systemetric/RoboCon-Brain/README.md

# RoboCon-Brain
Custom hardware and firmware for the RoboCon Brain, with PCB designs, embedded software and supporting files. Generations are documented through dedicated branches.
