systemetric/RoboCon-Brain/Hardware/PCB/PiLow/PiLow.kicad_pcb

## KiCad design Hardware/PCB/PiLow/PiLow.kicad_pcb (2026-10-25)

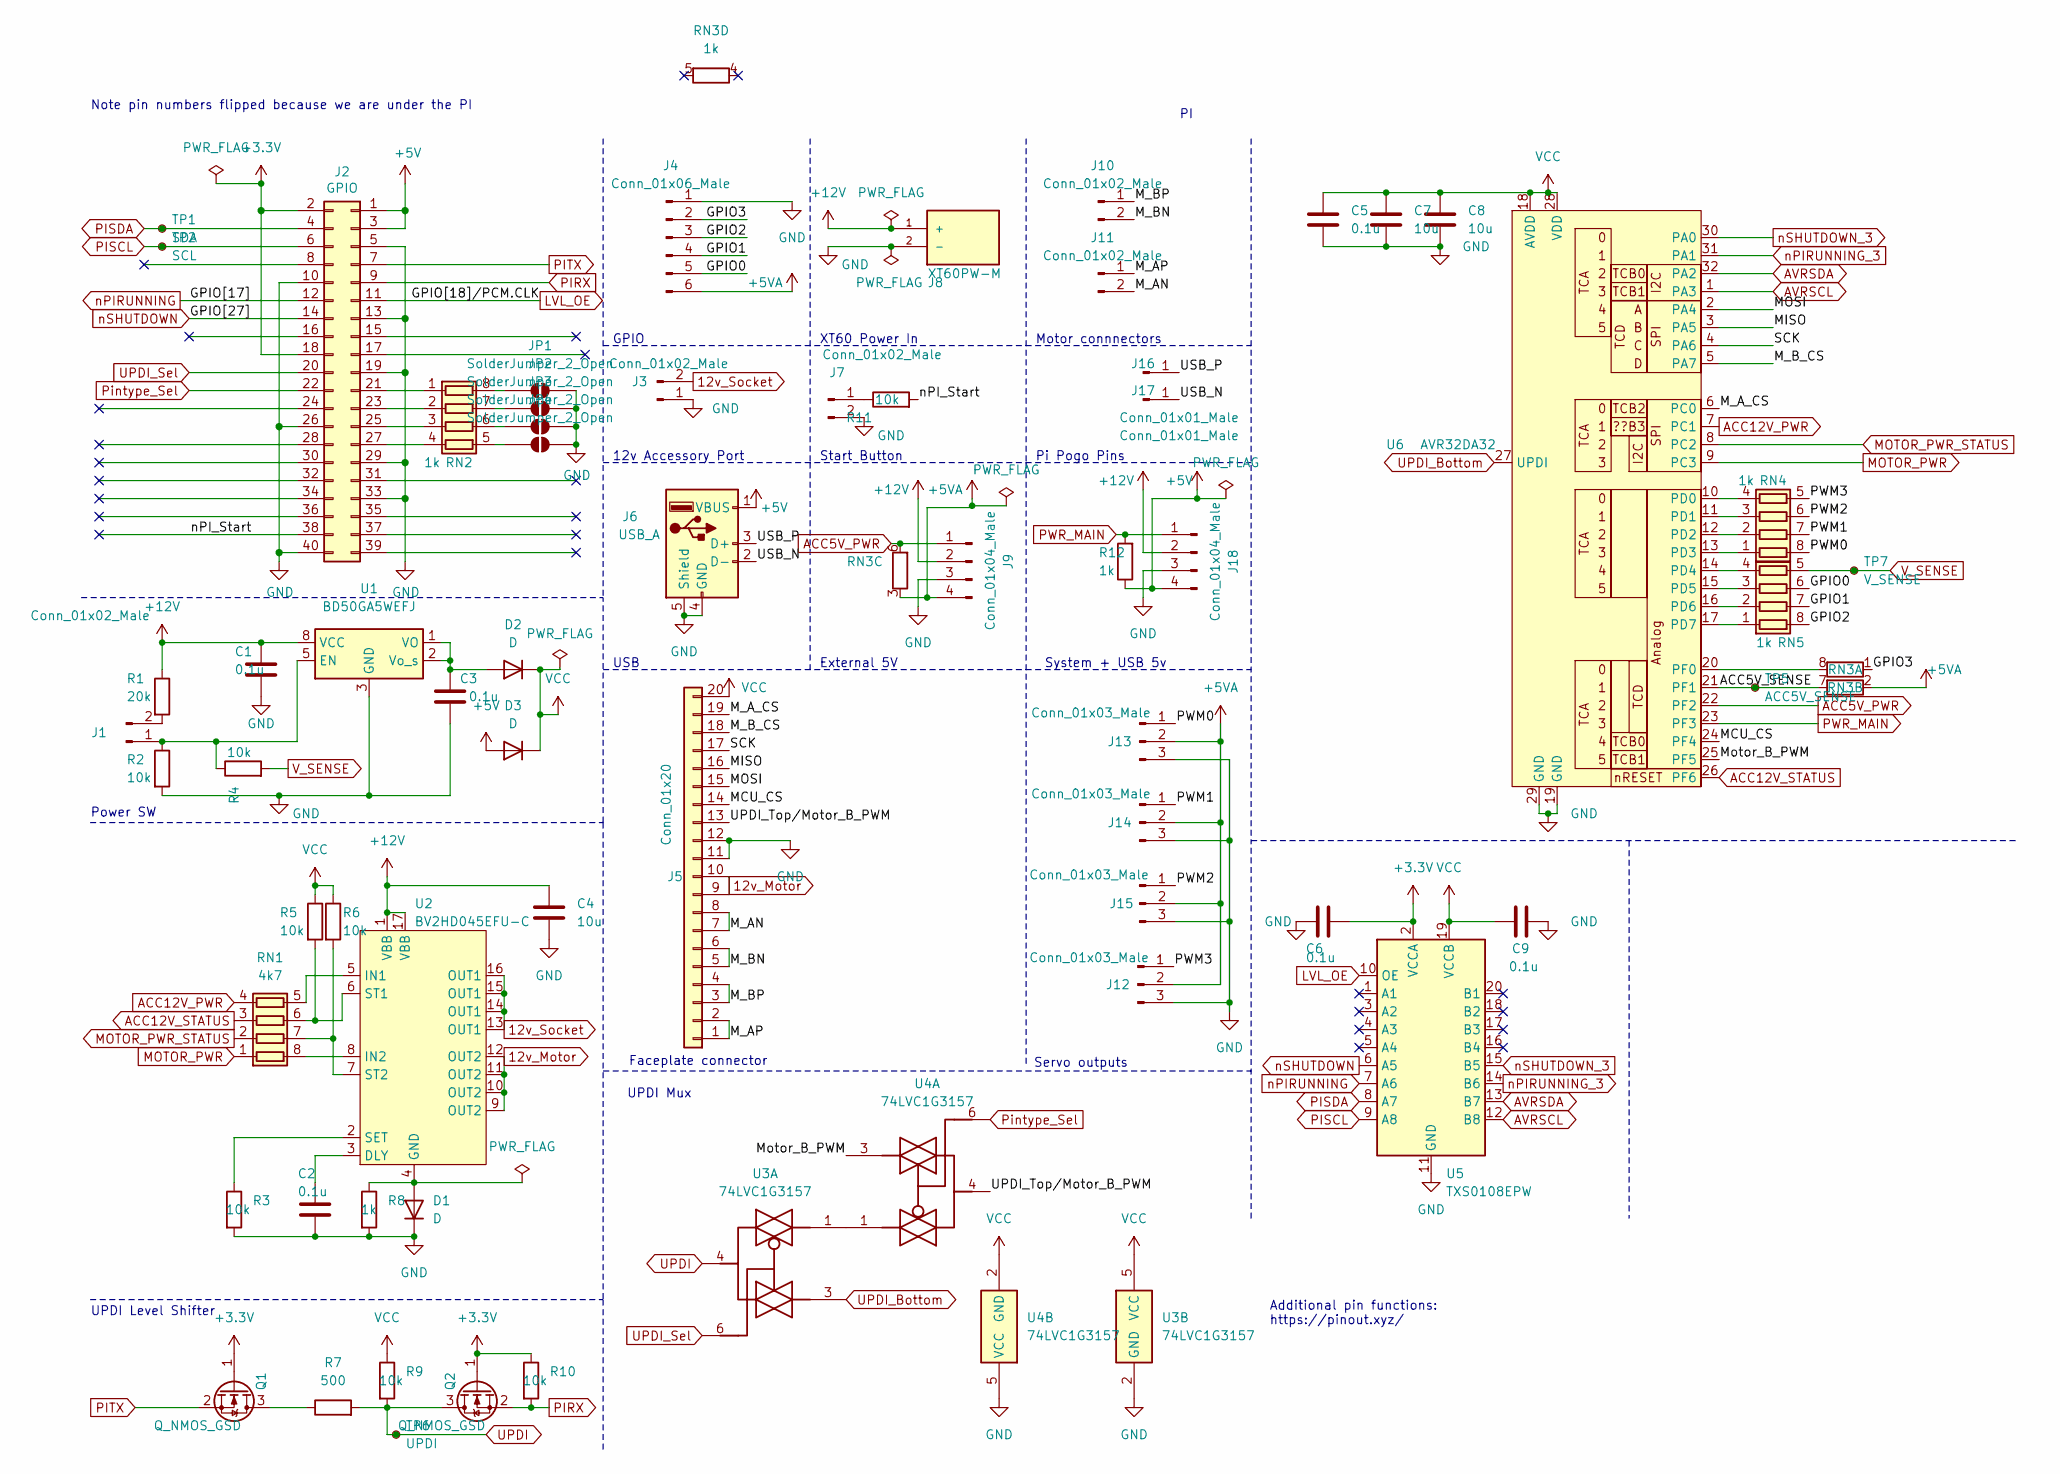
[picture p1: schematic PiLow.kicad_sch]

Parts:
C1, C2, C3, C5, C6, C9: 0.1u; C_0805_2012Metric_Pad1.18x1.45mm_HandSolder
C4, C7, C8: 10u; C_0805_2012Metric_Pad1.18x1.45mm_HandSolder
D1, D2, D3: D; D_SMA_Handsoldering
J1, J7: Conn_01x02_Male; PhoenixContact_MC_1,5_2-G-3.81_1x02_P3.81mm_Horizontal
J2: GPIO; PinSocket_2x20_P2.54mm_Vertical_SMD
J3, J10, J11: Conn_01x02_Male; PhoenixContact_MC_1,5_2-G-5.08_1x02_P5.08mm_Horizontal
J4: Conn_01x06_Male; PhoenixContact_MC_1,5_6-G-3.81_1x06_P3.81mm_Horizontal
J5: Conn_01x20; PinHeader_1x20_P2.54mm_Vertical
J6: USB_A; USB_A_Wuerth_614004134726_Horizontal
J8: XT60PW-M; AMASS_XT60PW-M; PARTREV V1.2
J9, J18: Conn_01x04_Male; PinHeader_1x04_P2.54mm_Vertical
J12, J13, J14, J15: Conn_01x03_Male; PinHeader_1x03_P2.54mm_Horizontal
J16, J17: Conn_01x01_Male; PinHeader_1x01_P2.54mm_Vertical
JP1, JP2, JP3, JP4: SolderJumper_2_Open; SolderJumper-2_P1.3mm_Open_TrianglePad1.0x1.5mm
Q1, Q2: Q_NMOS_GSD; SOT-23_Handsoldering
R1: 20k; R_0805_2012Metric_Pad1.20x1.40mm_HandSolder
R2, R3, R4, R5, R6, R9, R10, R11: 10k; R_0805_2012Metric_Pad1.20x1.40mm_HandSolder
R7: 500; R_0805_2012Metric_Pad1.20x1.40mm_HandSolder
R8, R12: 1k; R_0805_2012Metric_Pad1.20x1.40mm_HandSolder
RN1: 4k7; R_Array_Convex_4x0612
RN2, RN3, RN4, RN5: 1k; R_Array_Convex_4x0612
TP1: SDA; TestPoint_Pad_D1.5mm
TP2: SCL; TestPoint_Pad_D1.5mm
TP5: ACC5V_SENSE; TestPoint_Pad_D1.5mm
TP6: UPDI; TestPoint_Pad_D1.5mm
TP7: V_SENSE; TestPoint_Pad_D1.5mm
U1: BD50GA5WEFJ; HTSOP-8-1EP_3.9x4.9mm_P1.27mm_EP2.4x3.2mm
U2: BV2HD045EFU-C; HSSOP-C16
U3, U4: 74LVC1G3157; SOT-363_SC-70-6
U5: TXS0108EPW; TSSOP-20_4.4x6.5mm_P0.65mm
U6: AVR32DA32; TQFP-32_7x7mm_P0.8mm

Connections:
12v_Motor: J5.9, J5.10, U2.9 (OUT2), U2.10 (OUT2), U2.11 (OUT2), U2.12 (OUT2)
12v_Socket: J3.2, U2.13 (OUT1), U2.14 (OUT1), U2.15 (OUT1), U2.16 (OUT1)
+3.3V: C6.1, J2.2, J2.18, Q1.1 (G), Q2.1 (G), R10.1, U5.2 (VCCA)
+5V: D3.2 (A), J2.1, J2.3, J6.1 (VBUS), J18.4, R12.1
+5VA: J4.6, J9.4, J12.2, J13.2, J14.2, J15.2, RN3.2 (R2.1), RN3.3 (R3.1)
+12V: C1.1, C4.1, J8.1 (+), J9.2, J18.2, R1.1, U1.8 (VCC), U2.1 (VBB), U2.17 (VBB)
/ACC5V_SENSE: RN3.7 (R2.2), TP5.1 (1_1), U6.21 (PF1)
/GPIO0: J4.5, RN5.6 (R3.2)
/GPIO1: J4.4, RN5.7 (R2.2)
/GPIO2: J4.3, RN5.8 (R1.2)
/GPIO3: J4.2, RN3.1 (R1.1)
/MCU_CS: J5.14, U6.24 (PF4)
/MISO: J5.16, U6.3 (PA5)
/MOSI: J5.15, U6.2 (PA4)
/M_AN: J5.7, J5.8, J11.2
/M_AP: J5.1, J5.2, J11.1
/M_A_CS: J5.19, U6.6 (PC0)
/M_BN: J5.5, J5.6, J10.2
/M_BP: J5.3, J5.4, J10.1
/M_B_CS: J5.18, U6.5 (PA7)
/Motor_B_PWM: U4.3, U6.25 (PF5)
/PWM0: J13.1, RN4.8 (R1.2)
/PWM1: J14.1, RN4.7 (R2.2)
/PWM2: J15.1, RN4.6 (R3.2)
/PWM3: J12.1, RN4.5 (R4.2)
/SCK: J5.17, U6.4 (PA6)
/UPDI_Top/Motor_B_PWM: J5.13, U4.4
/USB_N: J6.2 (D-), J17.1 (Pin_1_1)
/USB_P: J6.3 (D+), J16.1 (Pin_1_1)
/nPI_Start: J2.38, R11.2
ACC5V_PWR: J9.1, RN3.6 (R3.2), U6.22 (PF2)
ACC12V_PWR: RN1.4 (R4.1), U6.7 (PC1)
ACC12V_STATUS: RN1.3 (R3.1), U6.26 (PF6)
AVRSCL: U5.12 (B8), U6.1 (PA3)
AVRSDA: U5.13 (B7), U6.32 (PA2)
GND: C1.2, C2.2, C3.2, C4.2, C5.2, C6.2, C7.2, C8.2, C9.2, D1.1 (K), J2.5, J2.10, J2.13, J2.19, J2.26, J2.29, J2.33, J2.40, J3.1, J4.1, J5.11, J5.12, J6.4 (GND), J6.5 (Shield), J7.2, J8.2 (-), J9.3, J12.3, J13.3, J14.3, J15.3, J18.3, JP1.2 (B), JP2.2 (B), JP3.2 (B), JP4.2 (B), R2.2, R3.2, R8.2, U1.3 (GND), U1.4 (GND), U1.6 (GND), U1.7 (GND), U1.9 (GND), U3.2 (GND), U4.5 (VCC), U5.11 (GND), U6.19 (GND), U6.29 (GND)
LVL_OE: J2.11, U5.10 (OE)
MOTOR_PWR: RN1.1 (R1.1), U6.9 (PC3)
MOTOR_PWR_STATUS: RN1.2 (R2.1), U6.8 (PC2)
unnamed: D1.2 (A), R8.1, U2.4 (GND)
unnamed: C3.1, D2.2 (A), U1.1 (VO), U1.2 (Vo_s)
unnamed: J1.1, R2.1, R4.1, U1.5 (EN)
unnamed: J1.2, R1.2
unnamed: J2.21, RN2.1 (R1.1)
unnamed: J2.23, RN2.2 (R2.1)
unnamed: J2.25, RN2.3 (R3.1)
unnamed: J2.27, RN2.4 (R4.1)
unnamed: J7.1, R11.1
unnamed: JP1.1 (A), RN2.8 (R1.2)
unnamed: JP2.1 (A), RN2.7 (R2.2)
unnamed: JP3.1 (A), RN2.6 (R3.2)
unnamed: JP4.1 (A), RN2.5 (R4.2)
unnamed: Q1.3 (D), R7.1
unnamed: RN1.8 (R1.2), U2.8 (IN2)
unnamed: R6.2, RN1.7 (R2.2), U2.7 (ST2)
unnamed: R5.2, RN1.6 (R3.2), U2.6 (ST1)
unnamed: RN1.5 (R4.2), U2.5 (IN1)
unnamed: RN3.8 (R1.2), U6.20 (PF0)
unnamed: RN4.1 (R1.1), U6.13 (PD3)
unnamed: RN4.2 (R2.1), U6.12 (PD2)
unnamed: RN4.3 (R3.1), U6.11 (PD1)
unnamed: RN4.4 (R4.1), U6.10 (PD0)
unnamed: RN5.1 (R1.1), U6.17 (PD7)
unnamed: RN5.2 (R2.1), U6.16 (PD6)
unnamed: RN5.3 (R3.1), U6.15 (PD5)
unnamed: RN5.4 (R4.1), U6.14 (PD4)
unnamed: C2.1, U2.3 (DLY)
unnamed: R3.1, U2.2 (SET)
unnamed: U3.1, U4.1
PIRX: J2.9, Q2.2 (S), R10.2
PISCL: J2.6, TP2.1 (1_1), U5.9 (A8)
PISDA: J2.4, TP1.1 (1_1), U5.8 (A7)
PITX: J2.7, Q1.2 (S)
PWR_MAIN: J18.1, R12.2, U6.23 (PF3)
Pintype_Sel: J2.22, U4.6
UPDI: Q2.3 (D), R7.2, R9.2, TP6.1 (1_1), U3.4
UPDI_Bottom: U3.3, U6.27 (UPDI)
UPDI_Sel: J2.20, U3.6
VCC: C5.1, C7.1, C8.1, C9.1, D2.1 (K), D3.1 (K), J5.20, R5.1, R6.1, R9.1, U3.5 (VCC), U4.2 (GND), U5.19 (VCCB), U6.18 (AVDD), U6.28 (VDD)
V_SENSE: R4.2, RN5.5 (R4.2), TP7.1 (1_1)
nPIRUNNING: J2.12, U5.7 (A6)
nPIRUNNING_3: U5.14 (B6), U6.31 (PA1)
nSHUTDOWN: J2.14, U5.6 (A5)
nSHUTDOWN_3: U5.15 (B5), U6.30 (PA0)

Notes on the sheet:
USB
External 5V
Faceplate connector
Additional pin functions: https://pinout.xyz/
Pi Pogo Pins
12v Accessory Port
UPDI Level Shifter
System + USB 5v
Servo outputs
Power SW
XT60 Power In
Start Button
UPDI Mux
GPIO
Note pin numbers flipped because we are under the PI
Motor connnectors

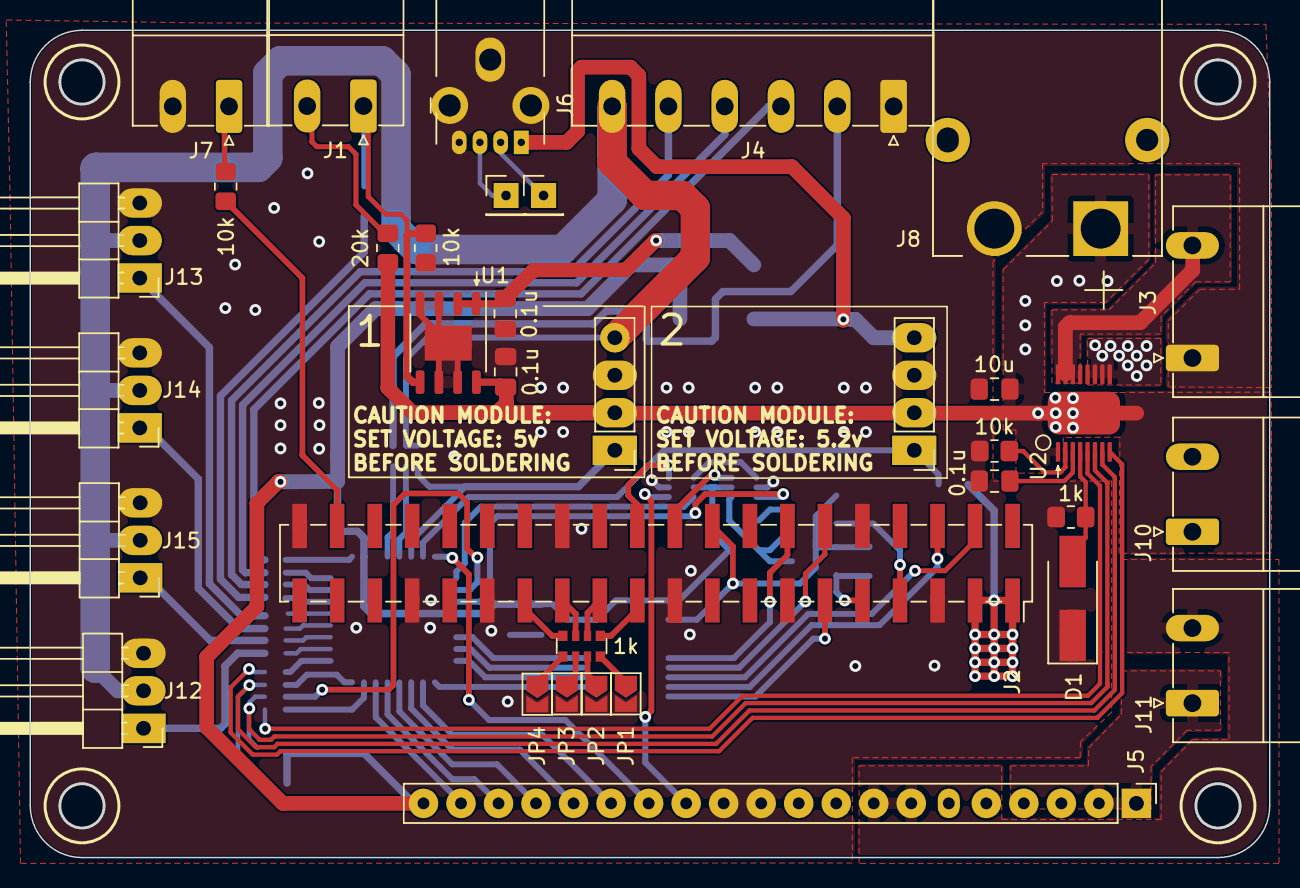
[picture p2: board PiLow.kicad_pcb from above]

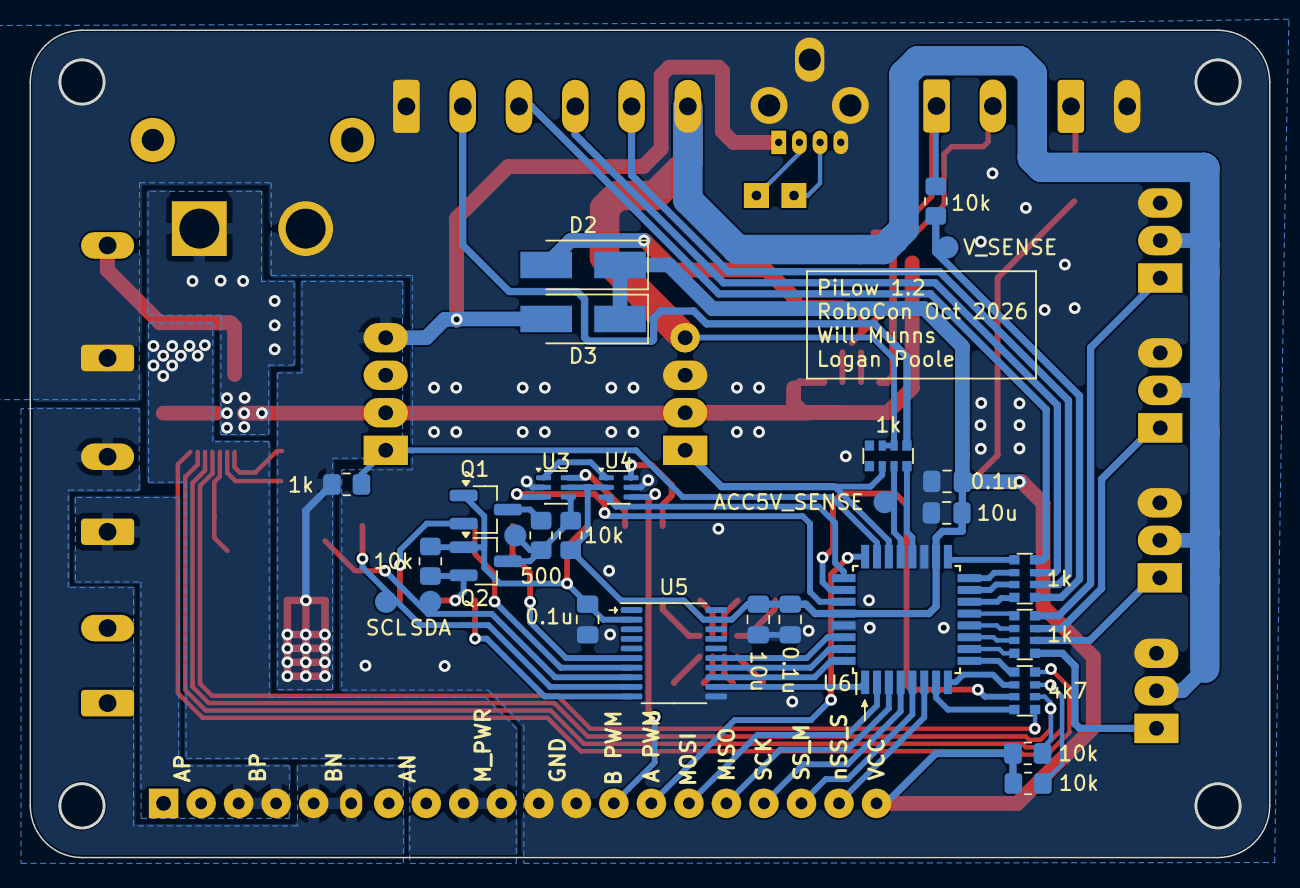
[picture p3: board PiLow.kicad_pcb from below]

Board: 2 copper layers, 83.9 x 56.0 mm, 64 parts (29 on the bottom side), 84 nets.
