systemetric/RoboCon-Brain/Hardware/PCB/PiLow Cover/PiLowCover.kicad_pcb

## KiCad design Hardware/PCB/PiLow Cover/PiLowCover.kicad_pcb (2026-10-25)

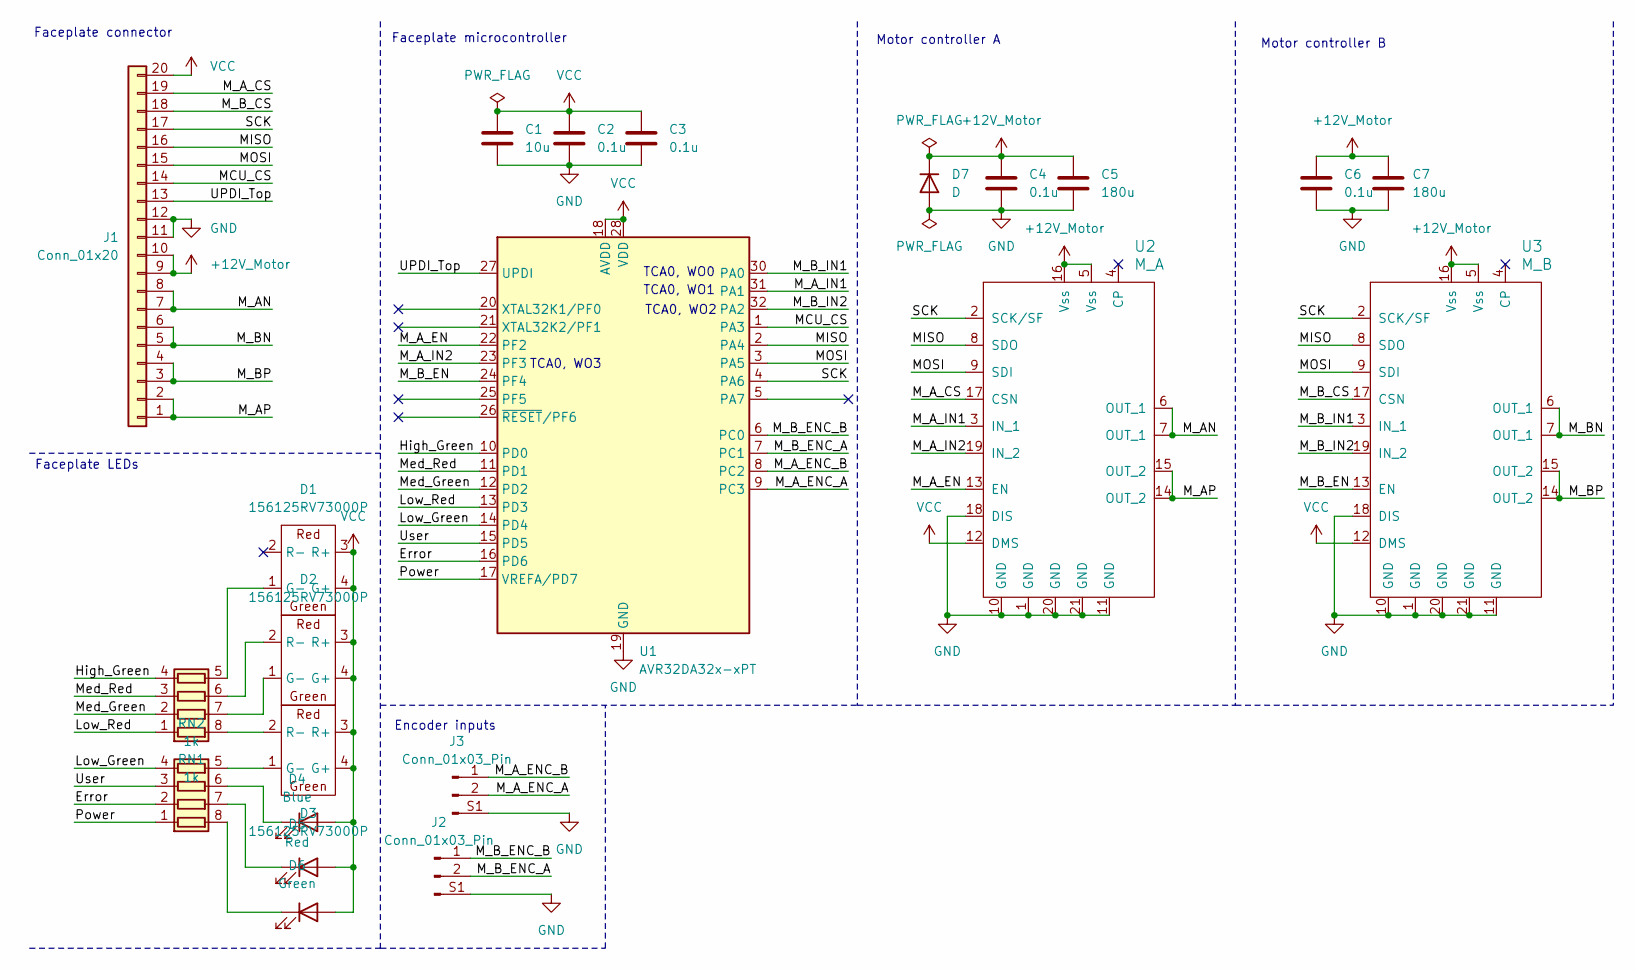
[picture p4: schematic PiLowCover.kicad_sch, PiLow Cover]

Parts:
C1: 10u; C_0805_2012Metric_Pad1.18x1.45mm_HandSolder
C2, C3, C4, C6: 0.1u; C_0805_2012Metric_Pad1.18x1.45mm_HandSolder
C5, C7: 180u; CP_Elec_6.3x5.4
D1, D2, D3: 156125RV73000P; WL-SBRW
D4: Blue; WL-SMRW
D5: Red; WL-SMRW
D6: Green; WL-SMRW
D7: D; D_SMA_Handsoldering
J1: Conn_01x20; PinHeader_1x20_P2.54mm_Vertical_SMD_Pin1Left
J2, J3: Conn_01x03_Pin; JST_S2B-PH-SM4-TB_LF__SN_
RN1, RN2: 1k; R_Array_Convex_4x0612
U1: AVR32DA32x-xPT; TQFP-32_7x7mm_P0.8mm
U2: M_A; HSOP-20-1EP_11.0x15.9mm_P1.27mm_SlugDown_ThermalVias
U3: M_B; HSOP-20-1EP_11.0x15.9mm_P1.27mm_SlugDown_ThermalVias

Connections:
+12V_Motor: C4.1, C5.1, C6.1, C7.1, D7.1 (K), J1.9, J1.10, U2.5 (Vss), U2.16 (Vss), U3.5 (Vss), U3.16 (Vss)
/Error: RN2.2 (R2.1), U1.16 (PD6)
/High_Green: RN1.4 (R4.1), U1.10 (PD0)
/Low_Green: RN2.4 (R4.1), U1.14 (PD4)
/Low_Red: RN1.1 (R1.1), U1.13 (PD3)
/MCU_CS: J1.14, U1.1 (PA3)
/MISO: J1.16, U1.2 (PA4), U2.8 (SDO), U3.8 (SDO)
/MOSI: J1.15, U1.3 (PA5), U2.9 (SDI), U3.9 (SDI)
/M_AN: J1.7, J1.8, U2.6 (OUT_1), U2.7 (OUT_1)
/M_AP: J1.1, J1.2, U2.14 (OUT_2), U2.15 (OUT_2)
/M_A_CS: J1.19, U2.17 (CSN)
/M_A_EN: U1.22 (PF2), U2.13 (EN)
/M_A_ENC_A: J3.2, U1.9 (PC3)
/M_A_ENC_B: J3.1, U1.8 (PC2)
/M_A_IN1: U1.31 (PA1), U2.3 (IN_1)
/M_A_IN2: U1.23 (PF3), U2.19 (IN_2)
/M_BN: J1.5, J1.6, U3.6 (OUT_1), U3.7 (OUT_1)
/M_BP: J1.3, J1.4, U3.14 (OUT_2), U3.15 (OUT_2)
/M_B_CS: J1.18, U3.17 (CSN)
/M_B_EN: U1.24 (PF4), U3.13 (EN)
/M_B_ENC_A: J2.2, U1.7 (PC1)
/M_B_ENC_B: J2.1, U1.6 (PC0)
/M_B_IN1: U1.30 (PA0), U3.3 (IN_1)
/M_B_IN2: U1.32 (PA2), U3.19 (IN_2)
/Med_Green: RN1.2 (R2.1), U1.12 (PD2)
/Med_Red: RN1.3 (R3.1), U1.11 (PD1)
/Power: RN2.1 (R1.1), U1.17 (VREFA/PD7)
/SCK: J1.17, U1.4 (PA6), U2.2 (SCK/SF), U3.2 (SCK/SF)
/UPDI_Top: J1.13, U1.27 (UPDI)
/User: RN2.3 (R3.1), U1.15 (PD5)
GND: C1.2, C2.2, C3.2, C4.2, C5.2, C6.2, C7.2, D7.2 (A), J1.11, J1.12, J2.S1 (Pin_3), J2.S2 (Pin_4), J3.S1 (Pin_3), J3.S2 (Pin_4), U1.19 (GND), U1.29 (GND), U2.1 (GND), U2.10 (GND), U2.11 (GND), U2.18 (DIS), U2.20 (GND), U2.21 (GND), U3.1 (GND), U3.10 (GND), U3.11 (GND), U3.18 (DIS), U3.20 (GND), U3.21 (GND)
unnamed: D1.1 (G-), RN1.5 (R4.2)
unnamed: D2.1 (G-), RN1.7 (R2.2)
unnamed: D2.2 (R-), RN1.6 (R3.2)
unnamed: D3.1 (G-), RN2.5 (R4.2)
unnamed: D3.2 (R-), RN1.8 (R1.2)
unnamed: D4.1 (K), RN2.6 (R3.2)
unnamed: D5.1 (K), RN2.7 (R2.2)
unnamed: D6.1 (K), RN2.8 (R1.2)
VCC: C1.1, C2.1, C3.1, D1.3 (R+), D1.4 (G+), D2.3 (R+), D2.4 (G+), D3.3 (R+), D3.4 (G+), D4.2 (A), D5.2 (A), D6.2 (A), J1.20, U1.18 (AVDD), U1.28 (VDD), U2.12 (DMS), U3.12 (DMS)

Notes on the sheet:
TCA0, WO2
TCA0, WO0
Encoder inputs
Faceplate LEDs
Motor controller A
TCA0, WO3
Motor controller B
Faceplate microcontroller
Faceplate connector
TCA0, WO1

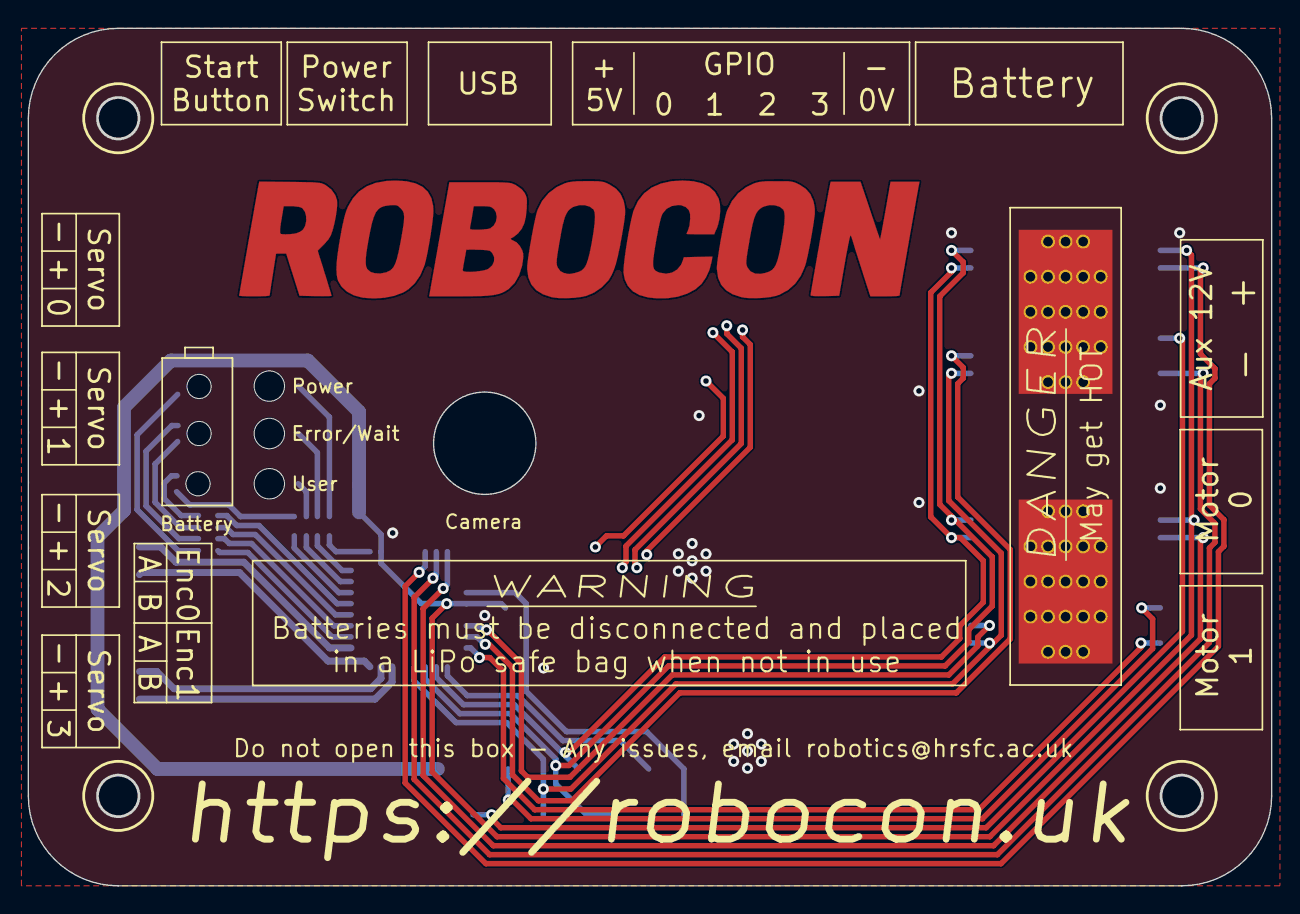
[picture p5: board PiLowCover.kicad_pcb from above]

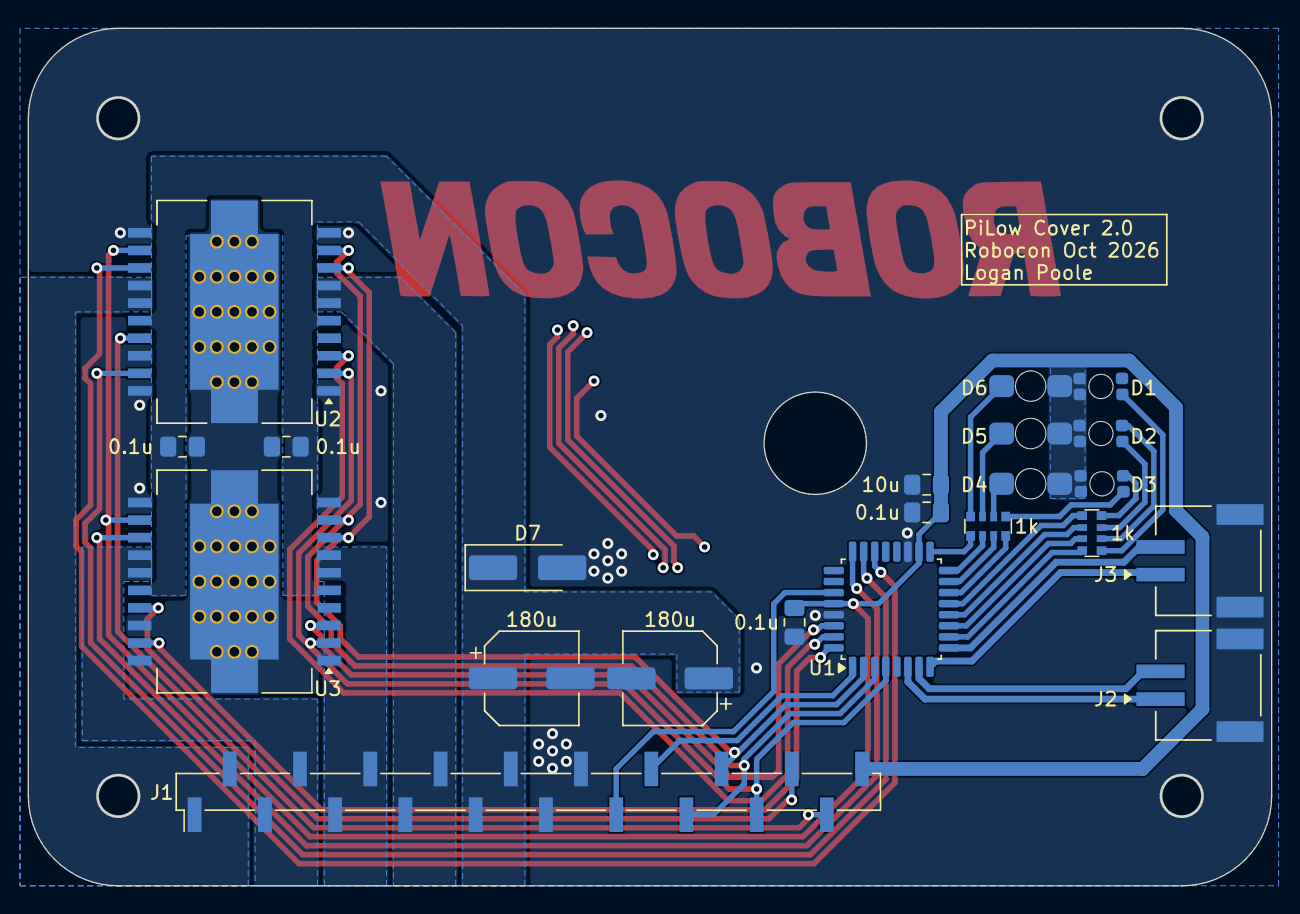
[picture p6: board PiLowCover.kicad_pcb from below]

Board: 2 copper layers, 89.9 x 62.0 mm, 22 parts (22 on the bottom side), 40 nets.
